jgallagher59701/HAST_leaf_node_pcb/README.md

# HAST leaf node pcb files

The first PCB used EagleCAD, but I've switched to KiCAD. Version 0.5 is the current version of the PCB in used as of Nov. 2021.

Supportted by a grant from ESIP.

Contact: jgallagher@opendap.org
