jgallagher59701/HAST_leaf_node_pcb/soil_moisture_0.5/soil_moisture_0.5.xlsx

Reference | Quantity | Value | Footprint | Description | Manufacturer_Name | Manufacturer_Part_Number | Digikey Part Number | Digikey Price/Stock | Total | Page
BT1 BT2 | 2 | BATTERY-AA | soil_moisture:BATTERY-AA-KIT |  |  | BK-92 | BK-92-ND | $0.38 | $0.76 | https://www.digikey.com/en/products/detail/mpd-memory-protection-devices/BK-92/2079904
C1 | 1 | 100nF | footprints:C322C104K5R5TA |  |  | C322C104K5R5TA | 399-4329-ND | $0.24 | $0.24 | https://www.digikey.com/en/products/detail/kemet/C322C104K5R5TA/818105
J1 | 1 | PPTC021LFBN-RC | soil_moisture:CONN2_LFBN-RC_SUL |  |  | PPTC021LFBN-RC | S7000-ND | $0.32 | $0.32 | https://www.digikey.com/en/products/detail/sullins-connector-solutions/PPTC021LFBN-RC/810142
J2 | 1 | 1725698 | soil_moisture:CONN_1725698_PXC |  | Phoenix Contact | 1725698 | 277-1277-ND | $4.97 | $4.97 | https://www.digikey.com/en/products/detail/phoenix-contact/1725698/267466
Q1 | 1 | FDP7030BL | soil_moisture:TO220 | Trans MOSFET N-CH 30V 60A 3-Pin TO-220 | ON Semiconductor | FDP7030BL | FDP7030BLFS-ND | $1.65 | $1.65 | https://www.digikey.com/en/products/detail/onsemi/FDP7030BL/976591
R1 R2 | 2 | 1M | Resistor_THT:R_Axial_DIN0207_L6.3mm_D2.5mm_P7.62mm_Horizontal |  | Stackpole Electronics Inc | CF14JT1M00 | CF14JT1M00CT-ND | $0.10 | $0.20 | https://www.digikey.com/en/products/detail/stackpole-electronics-inc/CF14JT1M00/1830423
R3 R4 R5 | 3 | 10k | Resistor_THT:R_Axial_DIN0207_L6.3mm_D2.5mm_P7.62mm_Horizontal |  | Stackpole Electronics Inc | CF14JT10K0 | CF14JT10K0CT-ND | $0.10 | $0.30 | https://www.digikey.com/en/products/detail/stackpole-electronics-inc/CF14JT10K0/1830374
 | 1 | uFL antenna | N/A | uFL ant connector + coax | Linx Technologies Inc. | CSI-UFFR-200-UFFR | CSI-UFFR-200-UFFR-ND | $2.78 | $2.78 | https://www.digikey.com/en/products/detail/linx-technologies-inc/CSI-UFFR-200-UFFR/7908410
 | 2 | 19 pin Connector |  | Connector for RocketScream | Sullins Connector Solutions | PPTC191LFBN-RC | S7017-ND | $1.17 | $2.34 | https://www.digikey.com/en/products/detail/sullins-connector-solutions/PPTC191LFBN-RC/810157
 | 1 | uSD | N/A. -40C card, cheapest with decent quantity. | Memory | Swissbit | SFSD2048N3BM1TO-I-GE-2CP-STD | 1052-1260-ND | $26.01 | $26.01 | https://www.digikey.com/en/products/detail/swissbit/SFSD2048N3BM1TO-I-GE-2CP-STD/6572651
U1 | 1 | RS_MINI_ULTRA_PRO_V3 | soil_moisture:RS_MINI_ULTRA_PRO_V2 |  |  |  |  | $35.00 | $35.00
U2 | 1 | SD_BREAKOUT_EBAY | soil_moisture:SD_BREAKOUT_EBAY |  |  |  |  | $2.00 | $2.00
 |  |  |  |  |  |  |  | Total: | $76.57
 |  |  |  |  |  |  | Adafruit Part number
 |  |  | Flanged Weatherproof Enclosure With PG-7 Cable Glands |  |  |  | 3931 | $9.99 |  | https://www.adafruit.com/product/3931
 |  |  | Small Plastic Project Enclosure - Weatherproof with Clear Top |  |  |  | 903 | $9.99 |  | https://www.adafruit.com/product/903
 |  |  | Cable Gland PG-7 size - 0.118" to 0.169" Cable Diameter - PG-7 |  |  |  | 762 | $1.95 |  | https://www.adafruit.com/product/762
 |  |  | Cable Gland PG-9 size - 0.158" to 0.252" Cable Diameter - PG-9 |  |  |  | 761 | $1.95 |  | https://www.adafruit.com/product/761
 |  |  | SHT-30 Mesh-protected Weather-proof Temperature/Humidity Sensor - 1M Cable |  |  |  | 4099 | $24.95 |  | https://www.adafruit.com/product/4099
 |  |  | NB: I used the G-7 Cable glands on the SHT-30 sensor cable even though it has a diameter of 0.2"
