jgallagher59701/HAST_leaf_node_pcb/soil_moisture_0.5/ul_C322C104K5R5TA/2021-09-06_19-10-46/STEP/CAP_C322_KEM.step

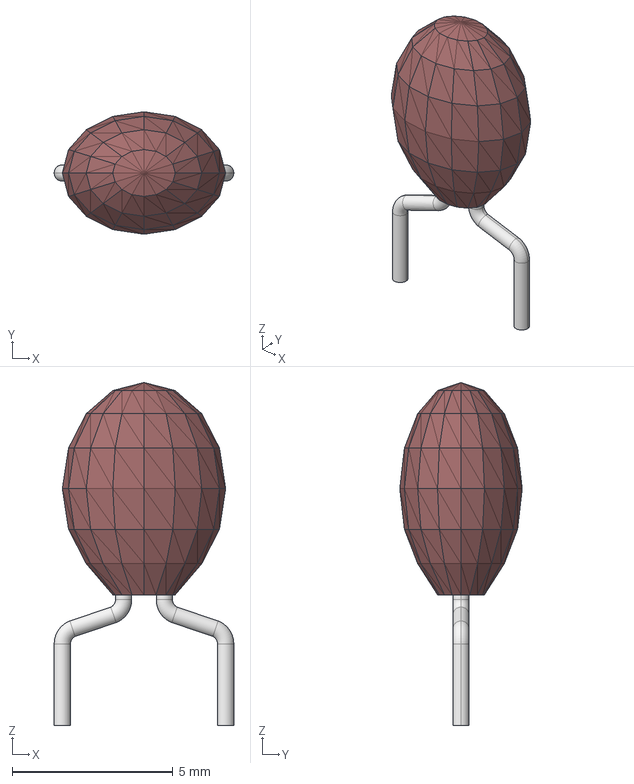
[picture p1: CAD file, 2021-09-07]
soil_moisture_0.5/ul_C322C104K5R5TA/2021-09-06_19-10-46/STEP/CAP_C322_KEM.step
5.59 x 3.81 x 10.7 mm
