jgallagher59701/HAST_leaf_node_pcb/soil_moisture_0.5/Schematic-0.5.pdf

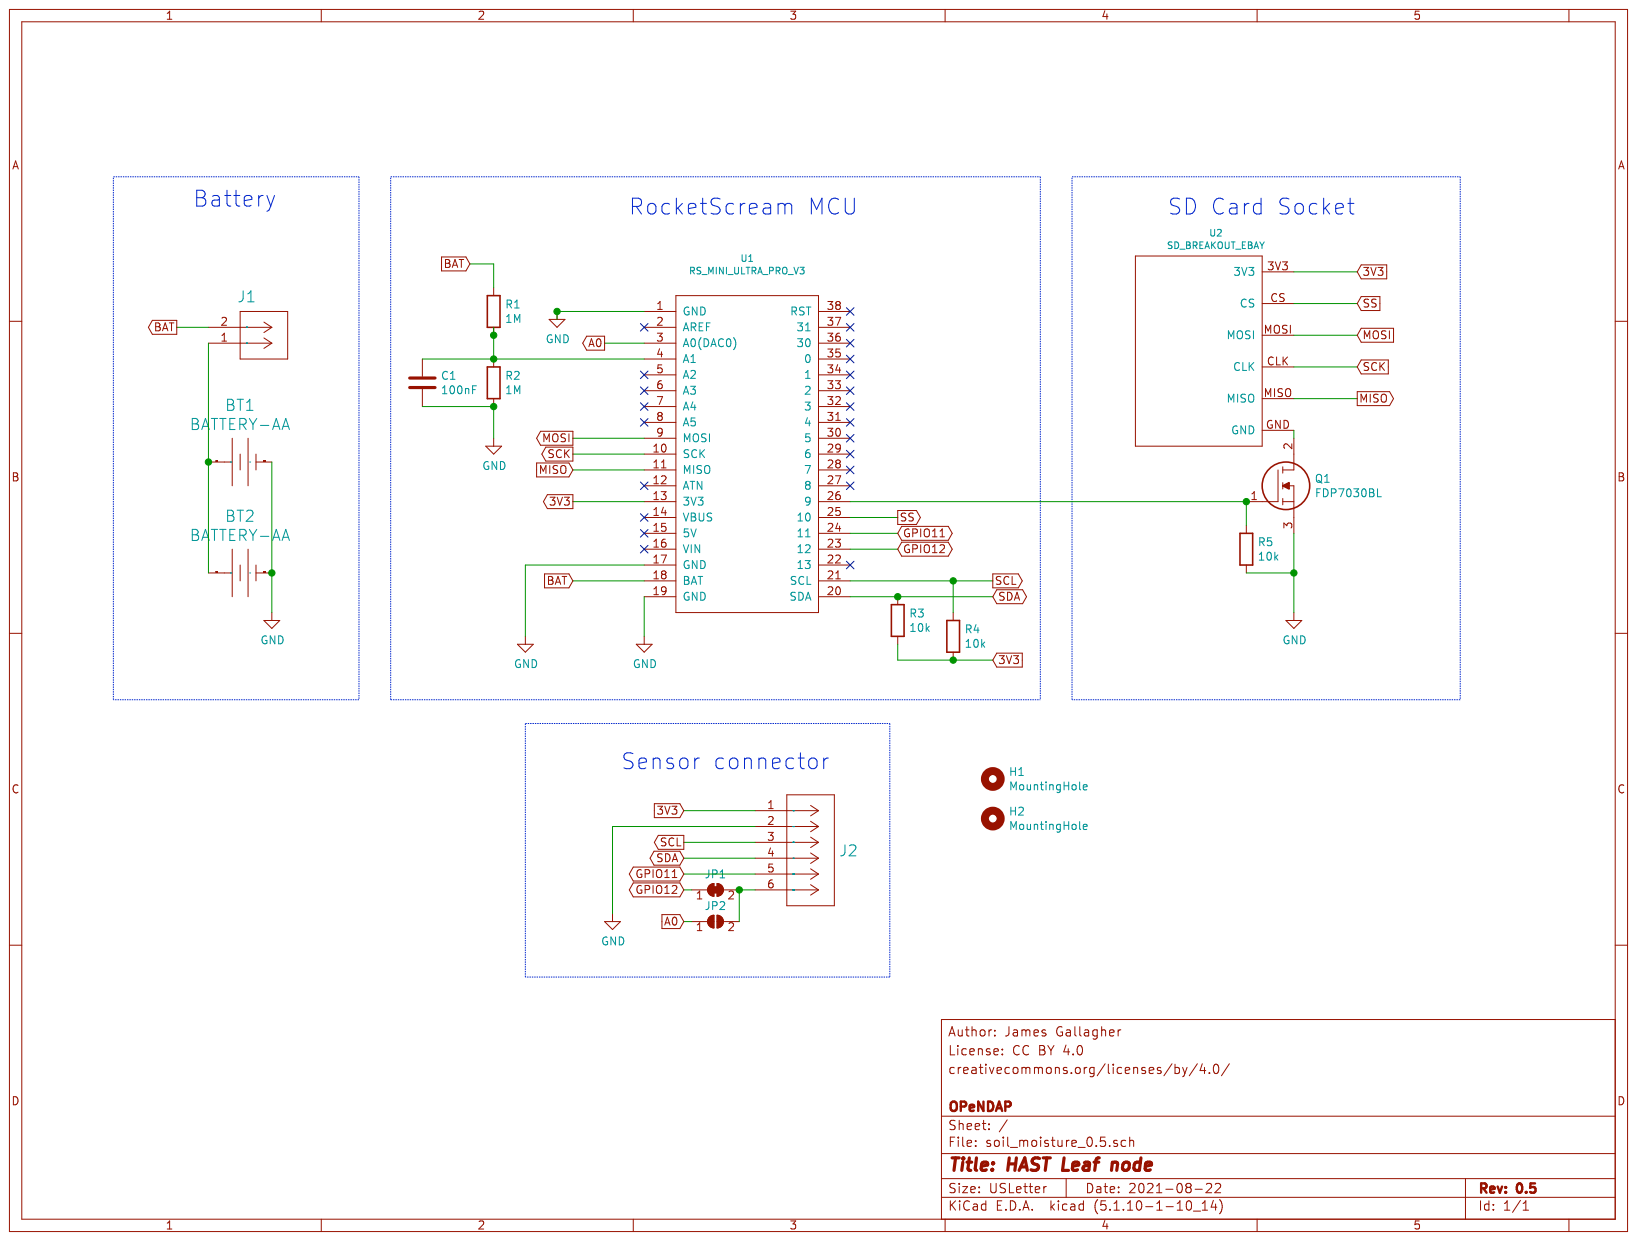
[picture p2: page 1]
