jgallagher59701/HAST_leaf_node_pcb/soil_moisture_0.5/soil_moisture_0.5.kicad_pcb

## KiCad design soil_moisture_0.5/soil_moisture_0.5.kicad_pcb (2021-09-09)

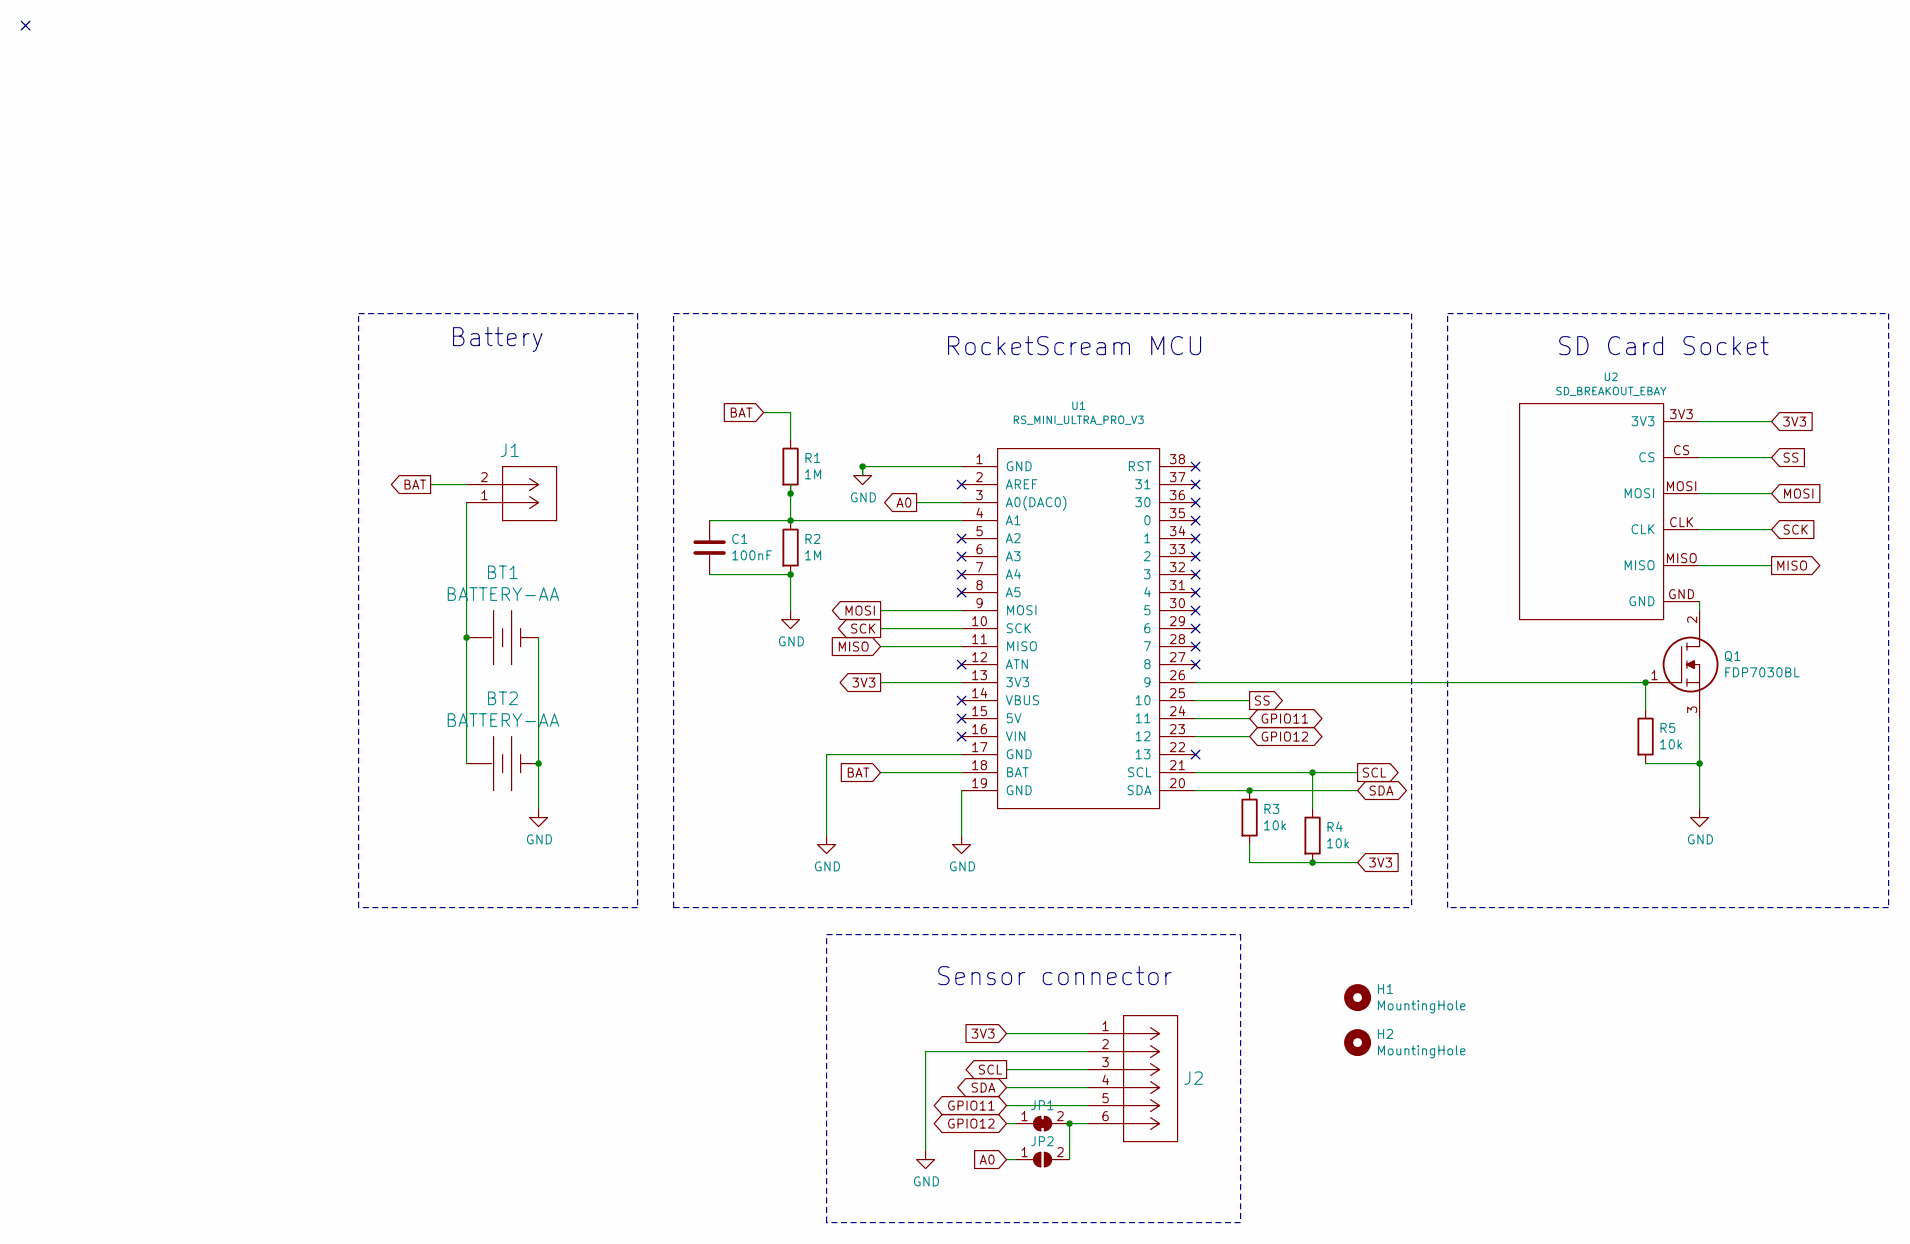
[picture p3: schematic soil_moisture_0.5.sch, HAST Leaf node]

Parts:
BT1, BT2: BATTERY-AA; BATTERY-AA-KIT
C1: 100nF; C322C104K5R5TA
H1, H2: MountingHole; MountingHole_4.3mm_M4
J1: PPTC021LFBN-RC; CONN2_LFBN-RC_SUL
J2: 1725698; CONN_1725698_PXC
JP1: SolderJumper_2_Bridged; SolderJumper-2_P1.3mm_Bridged_RoundedPad1.0x1.5mm
JP2: SolderJumper_2_Open; SolderJumper-2_P1.3mm_Open_RoundedPad1.0x1.5mm
Q1: FDP7030BL; TO220; Manufacturer_Part_Number FDP7030BL; Mouser Part Number 512-FDP7030BL
R1, R2: 1M; R_Axial_DIN0207_L6.3mm_D2.5mm_P7.62mm_Horizontal
R3, R4, R5: 10k; R_Axial_DIN0207_L6.3mm_D2.5mm_P7.62mm_Horizontal
U1: RS_MINI_ULTRA_PRO_V3; RS_MINI_ULTRA_PRO_V2
U2: SD_BREAKOUT_EBAY

Connections:
3V3: J2.1, R3.2, R4.2, U1.13 (3V3), U2.3V3
A0: JP2.1 (A), U1.3 (A0(DAC0))
BAT: J1.2, R1.1, U1.18 (BAT)
GND: BT1.GND@1 (-), BT2.GND@1 (-), C1.2, J2.2, Q1.3, R2.2, R5.2, U1.1 (GND), U1.17 (GND), U1.19 (GND)
GPIO11: J2.5, U1.24 (11)
GPIO12: JP1.1 (A), U1.23 (12)
MISO: U1.11 (MISO), U2.MISO
MOSI: U1.9 (MOSI), U2.MOSI
unnamed: BT1.PWR@1 (+), BT2.PWR@1 (+), J1.1
unnamed: C1.1, R1.2, R2.1, U1.4 (A1)
unnamed: J2.6, JP1.2 (B), JP2.2 (B)
unnamed: Q1.1, R5.1, U1.26 (9)
unnamed: Q1.2, U2.GND
SCK: U1.10 (SCK), U2.CLK
SCL: J2.3, R4.1, U1.21 (SCL)
SDA: J2.4, R3.1, U1.20 (SDA)
SS: U1.25 (10), U2.CS

Notes on the sheet:
Sensor connector
Battery
RocketScream MCU
SD Card Socket

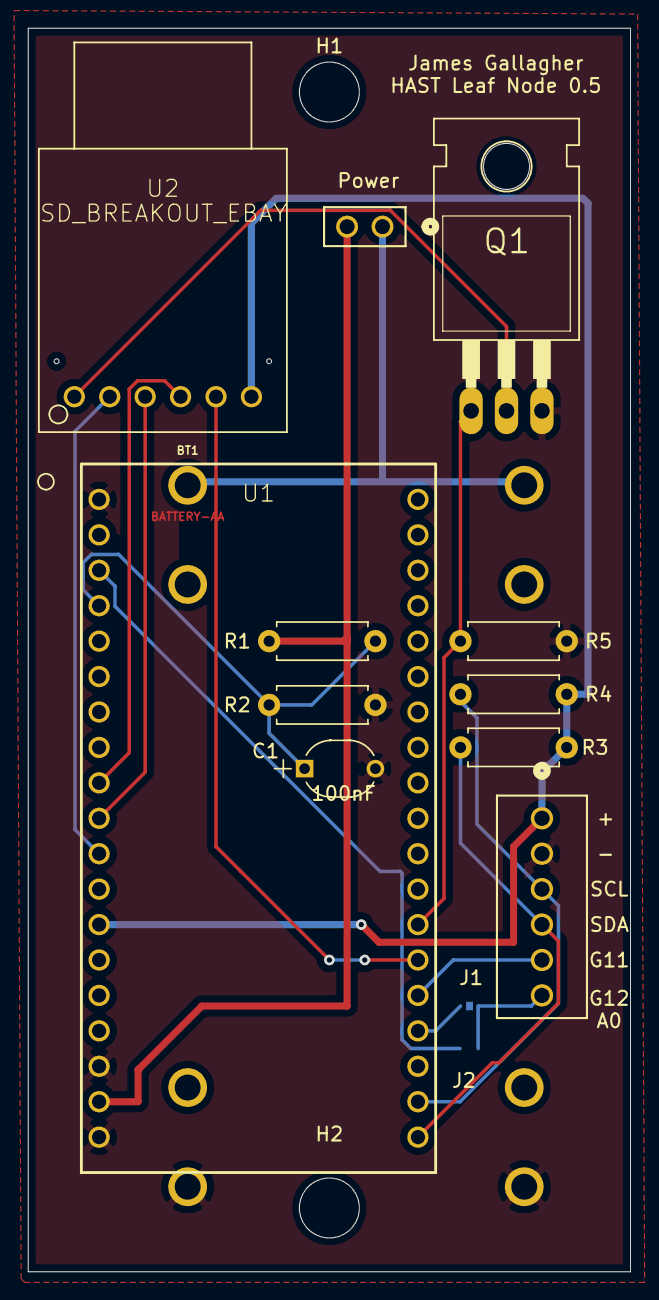
[picture p4: board soil_moisture_0.5.kicad_pcb from above]

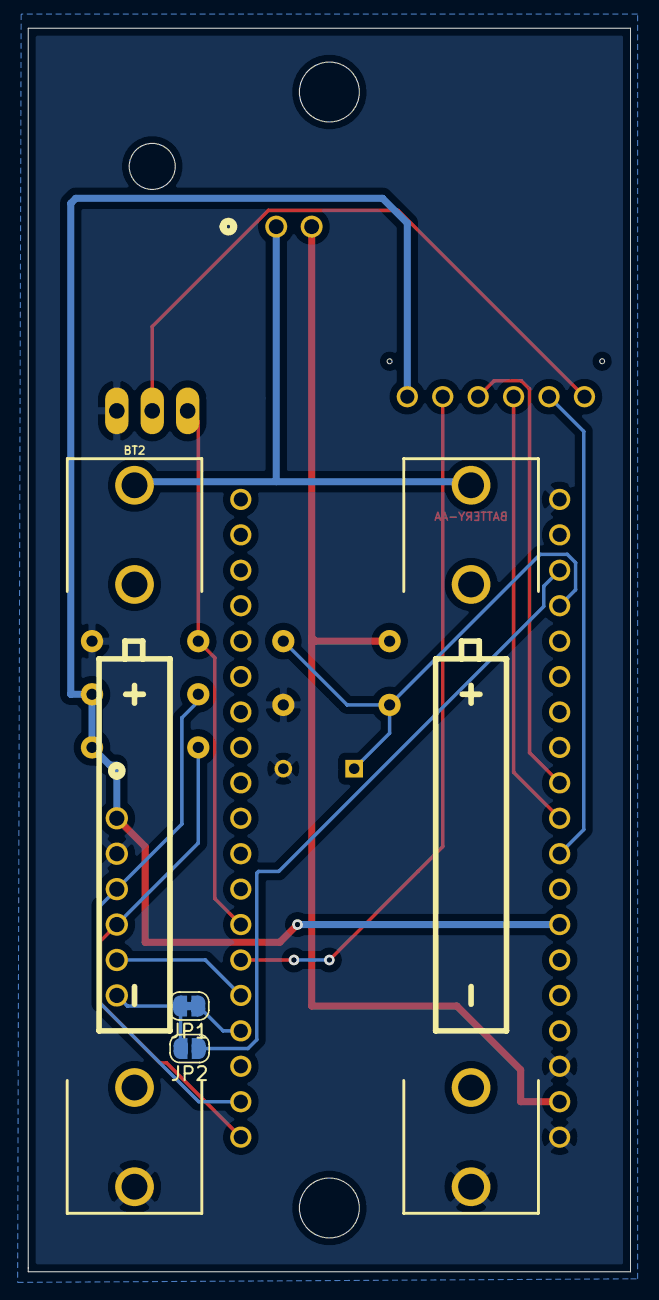
[picture p5: board soil_moisture_0.5.kicad_pcb from below]

Board: 2 copper layers, 43.2 x 89.2 mm, 17 parts (4 on the bottom side), 17 nets.
