jgallagher59701/HAST_leaf_node_pcb/KiCAD-5/Soil_moisture.kicad_pcb

## KiCad design KiCAD-5/Soil_moisture.kicad_pcb (2021-03-10)

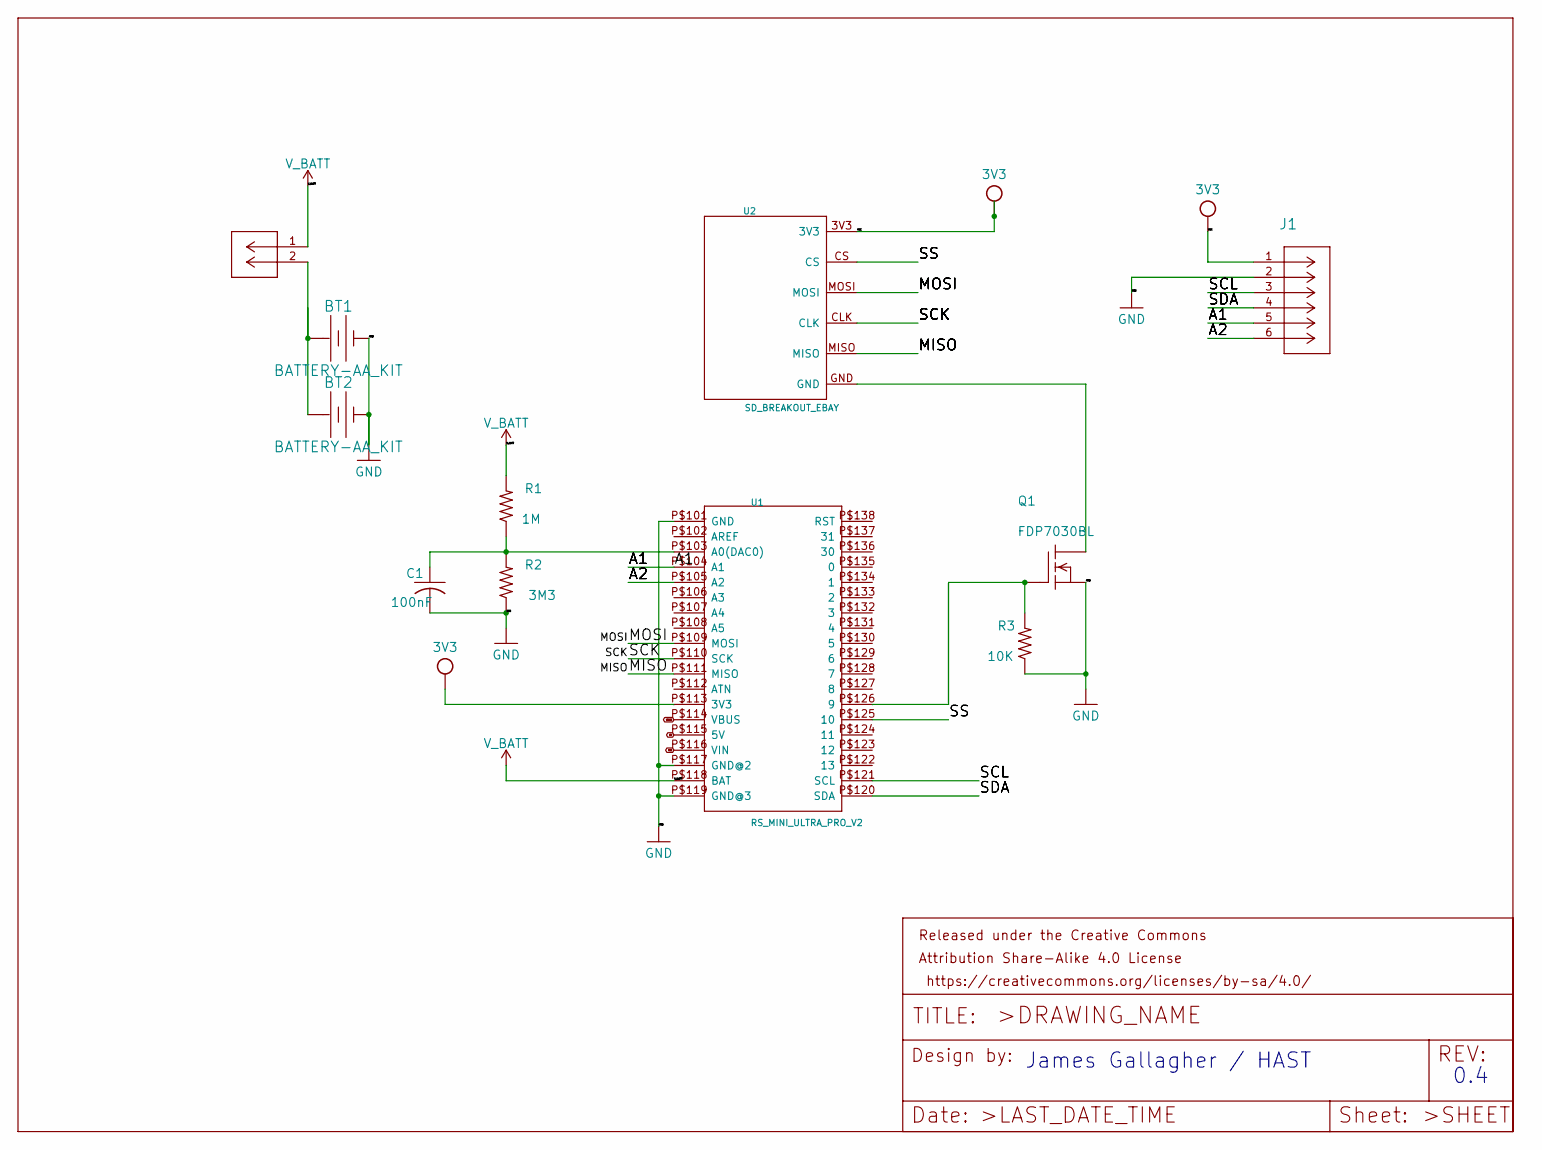
[picture p6: schematic Soil_moisture.sch]

Parts:
BAT_GND1: PPTC021LFBN-RC; CONN2_LFBN-RC_SUL
BT1, BT2: BATTERY-AA_KIT; BATTERY-AA-KIT
C1: 100nF; C050-035X075
FRAME1: FRAME-LETTER; CREATIVE_COMMONS
J1: 1725698; CONN_1725698_PXC
Q1: FDP7030BL; TO220
R1: 1M; 0309_10
R2: 3M3; 0309_10
R3: 10K; 0309_10
U1: RS_MINI_ULTRA_PRO_V2
U2: SD_BREAKOUT_EBAY

Connections:
5V: U1.P$115 (5V)
/A1: J1.5, U1.P$104 (A1)
/A2: J1.6, U1.P$105 (A2)
/MISO: U1.P$111 (MISO), U2.MISO
/MOSI: U1.P$109 (MOSI), U2.MOSI
/SCK: U1.P$110 (SCK), U2.CLK
/SCL: J1.3, U1.P$121 (SCL)
/SDA: J1.4, U1.P$120 (SDA)
/SS: U1.P$125 (10), U2.CS
GND: BT1.GND@1 (-), BT2.GND@1 (-), C1.2, J1.2, Q1.3 (S), R2.1, R3.1, U1.P$101 (GND), U1.P$117 (GND@2), U1.P$119 (GND@3)
unnamed: BAT_GND1.2, BT1.PWR@1 (+), BT2.PWR@1 (+)
unnamed: C1.1, R1.1, R2.2, U1.P$103 (A0(DAC0))
unnamed: Q1.1 (G), R3.2, U1.P$126 (9)
unnamed: Q1.2 (D), U2.GND
VBUS: U1.P$114 (VBUS)
VCC: J1.1, U1.P$113 (3V3), U2.3V3
VIN: U1.P$116 (VIN)
V_BATT: BAT_GND1.1, R1.2, U1.P$118 (BAT)

Notes on the sheet:
James Gallagher / HAST
0.4

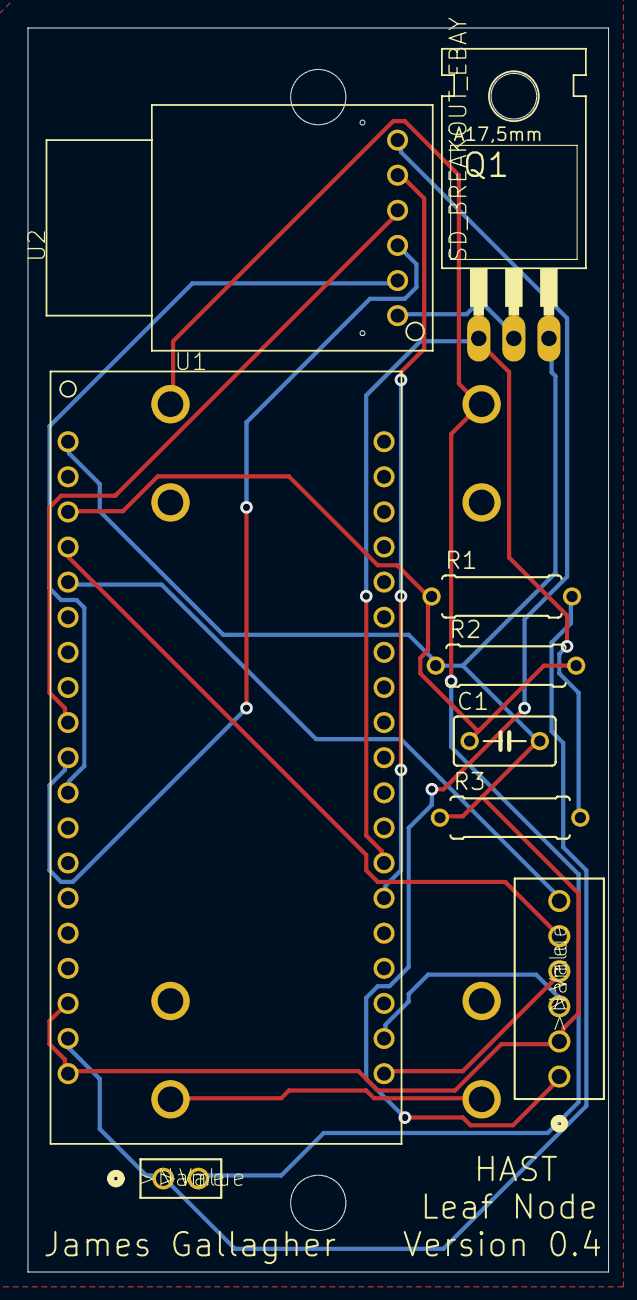
[picture p7: board Soil_moisture.kicad_pcb from above]

Board: 2 copper layers, 42.0 x 90.0 mm, 14 parts (0 on the bottom side), 15 nets.

Other parts of the board:
@HOLE0, @HOLE1: (no value)
