jgallagher59701/HAST_leaf_node_pcb/(commit log)

2021-03-10 Imported Eagle schematic to KiCAD, added the result here.
    [Soil_moisture.kicad_pcb, Soil_moisture.sch]
2021-03-10 Added a note about KiCAD 5 to the README
2021-08-27 PCB version 0.5 - now with 3D models
    [Soil_moisture.brd, Soil_moisture.brd.old.brd, Soil_moisture.sch, soil_moisture_0.5.kicad_pcb, soil_moisture_0.5.sch]
2021-08-28 Various hacks - added jumpers for GPIO/A0
    [soil_moisture_0.5.kicad_pcb, soil_moisture_0.5.sch]
2021-09-07 Added second voltage divider for Vbat; board outline
    [CAP_C322_KEM.step, soil_moisture_0.5.kicad_pcb, soil_moisture_0.5.sch]
2021-09-09 Added Gerbers and a BOM
    [soil_moisture_0.5-B_Cu.gbl, soil_moisture_0.5-B_Mask.gbs, soil_moisture_0.5-B_SilkS.gbo, soil_moisture_0.5-Edge_Cuts.gm1, soil_moisture_0.5-F_Cu.gtl, soil_moisture_0.5-F_Mask.gts, soil_moisture_0.5-F_SilkS.gto, soil_moisture_0.5.drl]
2021-09-13 BOM updates
    [soil_moisture_0.5.xlsx]
2021-10-01 Added a PDF of the schematic
