jgallagher59701/HAST_leaf_node_pcb/(notices)

Notices in the files:
soil_moisture_0.5/soil_moisture_0.5.kicad_pcb:
License: CC BY 4.0
soil_moisture_0.5/soil_moisture_0.5.sch:
creativecommons.org/licenses/by/4.0
parts and their libraries:
https://creativecommons.org/licenses/by-sa/4.0
Released under the Creative Commons Attribution Share-Alike 4.0 License
